sittner/ppp/smps/smps.kicad_pcb

## KiCad design power tram.kicad_sch

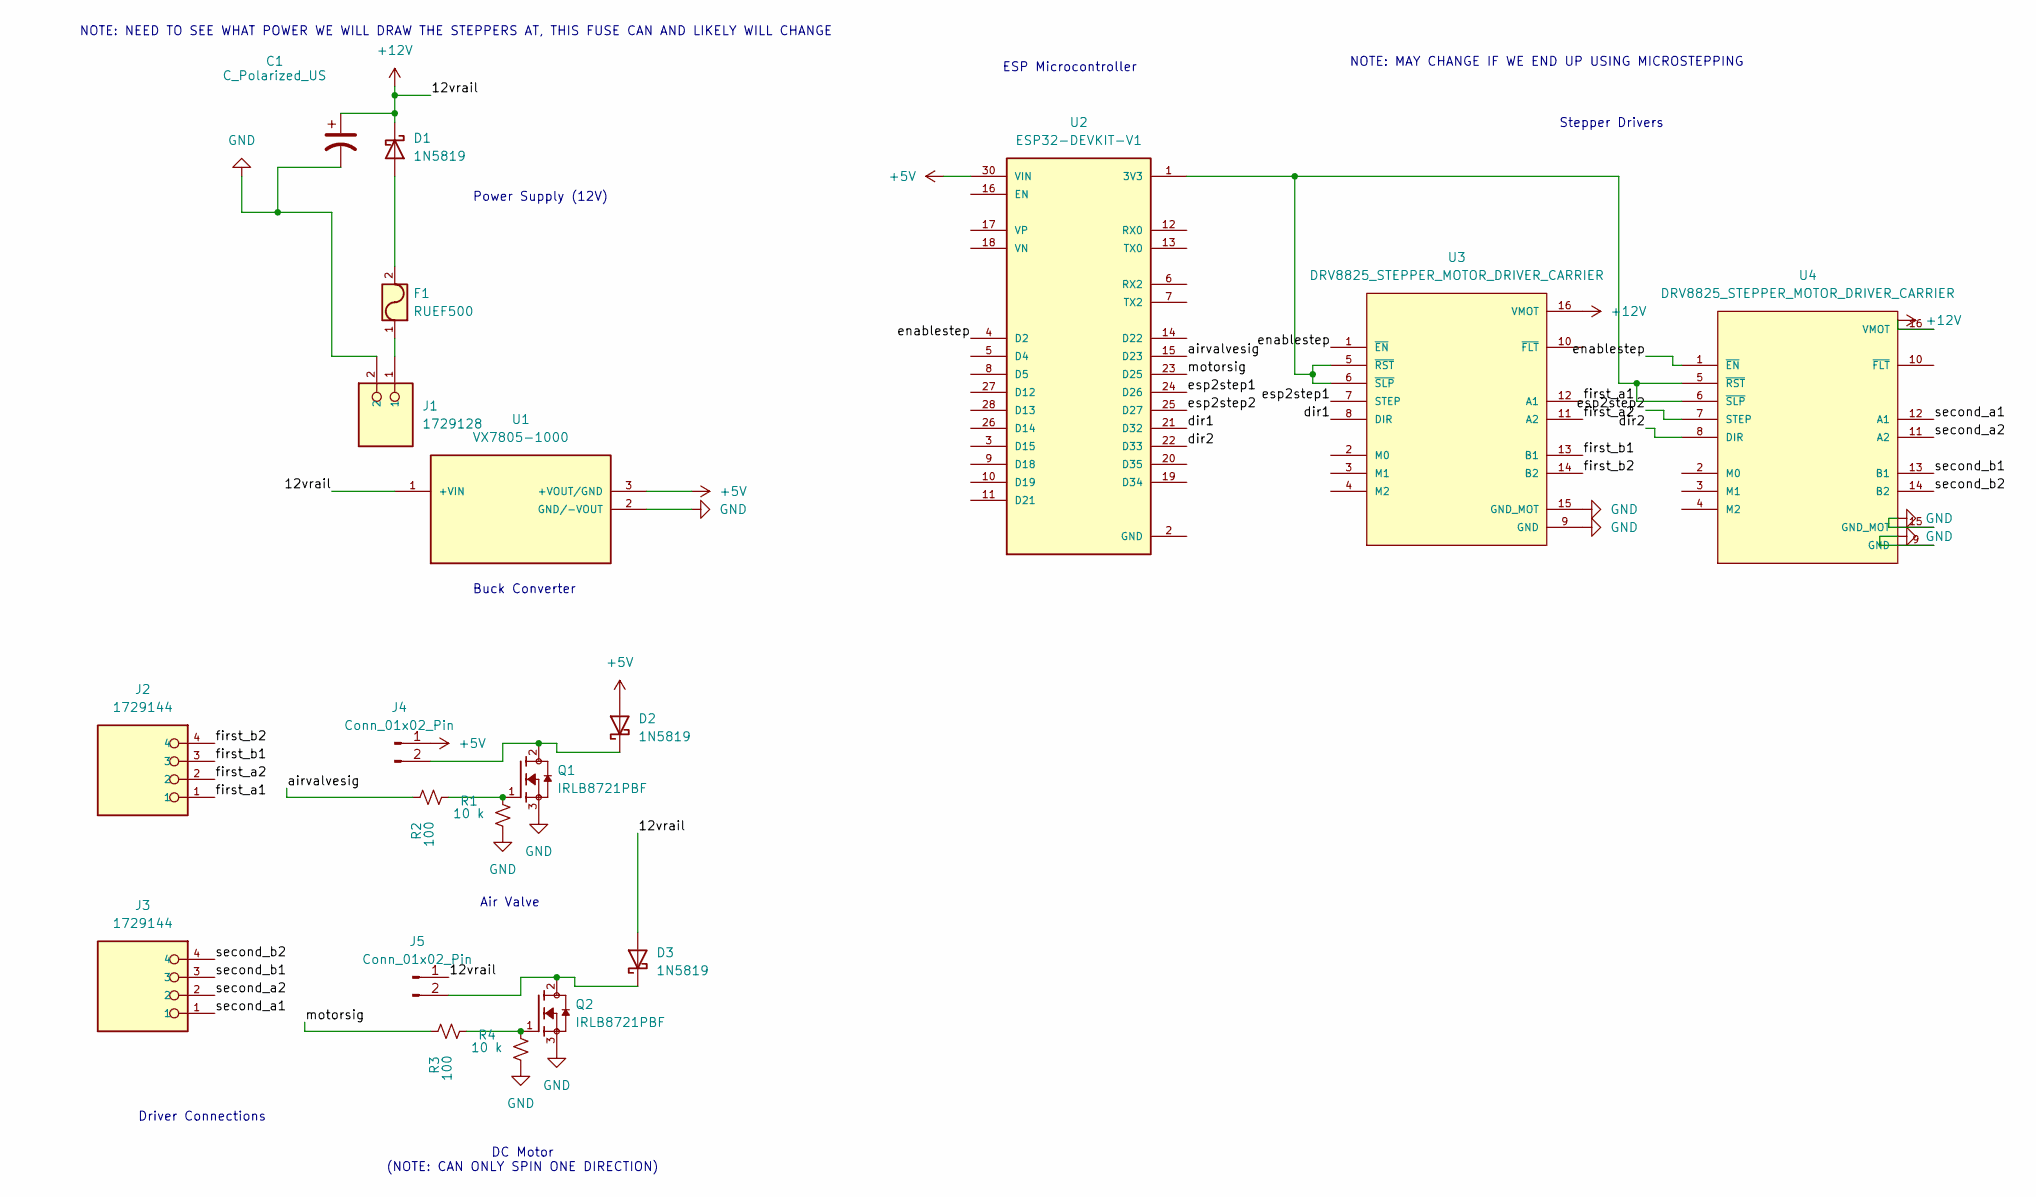
[picture p1: schematic power tram.kicad_sch]

Parts:
C1: C_Polarized_US; CP_Radial_D6.3mm_P2.50mm
D1, D2, D3: 1N5819; D_DO-41_SOD81_P10.16mm_Horizontal
F1: RUEF500; RUEF400; MANUFACTURER_PART_NUMBER RUEF500-2
J1: 1729128; PHOENIX_1729128; PARTREV 28.07.2023
J2, J3: 1729144; PHOENIX_1729144
J4, J5: Conn_01x02_Pin; JST_PH_B2B-PH-K_1x02_P2.00mm_Vertical
Q1, Q2: IRLB8721PBF; TO254P1067X483X2057-3; PARTREV 4/22/09
R1, R4: 10 k; R_Axial_DIN0207_L6.3mm_D2.5mm_P7.62mm_Horizontal
R2, R3: 100; R_Axial_DIN0207_L6.3mm_D2.5mm_P7.62mm_Horizontal
U1: VX7805-1000; VX78012-1000_VX7805-1000; PARTREV 1.0
U2: ESP32-DEVKIT-V1; MODULE_ESP32_DEVKIT_V1; PARTREV N/A
U3, U4: DRV8825_STEPPER_MOTOR_DRIVER_CARRIER; IC_DRV8825_STEPPER_MOTOR_DRIVER_CARRIER

Connections:
+5V: D2.2 (A), J4.1, U1.3 (+VOUT/GND), U2.30 (VIN)
+12V: C1.1, D1.1 (K), D3.2 (A), J5.1, U1.1 (+VIN), U3.16 (VMOT), U4.16 (VMOT)
GND: C1.2, J1.2, Q1.3, Q2.3, R1.2, R4.2, U1.2 (GND/-VOUT), U3.9 (GND), U3.15 (GND_MOT), U4.9 (GND), U4.15 (GND_MOT)
unnamed: D1.2 (A), F1.2
unnamed: D2.1 (K), J4.2, Q1.2
unnamed: D3.1 (K), J5.2, Q2.2
unnamed: F1.1, J1.1
unnamed: Q1.1, R1.1, R2.2
unnamed: Q2.1, R3.2, R4.1
unnamed: U2.1 (3V3), U3.5 (~RST), U3.6 (~SLP), U4.5 (~RST), U4.6 (~SLP)
unnamed: U2.2 (GND), U2.29 (GND)
airvalvesig: R2.1, U2.15 (D23)
dir1: U2.21 (D32), U3.8 (DIR)
dir2: U2.22 (D33), U4.8 (DIR)
enablestep: U2.4 (D2), U3.1 (~EN), U4.1 (~EN)
esp2step1: U2.24 (D26), U3.7 (STEP)
esp2step2: U2.25 (D27), U4.7 (STEP)
first_a1: J2.1, U3.12 (A1)
first_a2: J2.2, U3.11 (A2)
first_b1: J2.3, U3.13 (B1)
first_b2: J2.4, U3.14 (B2)
motorsig: R3.1, U2.23 (D25)
second_a1: J3.1, U4.12 (A1)
second_a2: J3.2, U4.11 (A2)
second_b1: J3.3, U4.13 (B1)
second_b2: J3.4, U4.14 (B2)

Notes on the sheet:
Buck Converter
Power Supply (12V)
Stepper Drivers
Air Valve
DC Motor (NOTE: CAN ONLY SPIN ONE DIRECTION)
NOTE: NEED TO SEE WHAT POWER WE WILL DRAW THE STEPPERS AT, THIS FUSE CAN AND LIKELY WILL CHANGE
Driver Connections
ESP Microcontroller
NOTE: MAY CHANGE IF WE END UP USING MICROSTEPPING
