sittner/ppp/(commit log)

2026-10-20 Add KiCad 9 schematic for PPP 6x EL34 power amp
    Mono amplifier sheet (A2) and mono half of the original stereo power
    supply (A3), linked via global labels. Project library with input,
    output and mains transformer symbols and an EL34 with fixed cathode pin.
    Mains transformer gets aux windings for the Ug bias supplies, output
    transformer uses 0/4/6/8 Ohm taps. ERC clean.
    [amp.kicad_sch, ppp.kicad_sch, supply.kicad_sch]
2026-10-20 Fix bias pot wiring: grid leak resistors to pot wiper
    R19..R24 now connect to the wiper (pin 2) of P1..P6; the pots form the
    divider between the 33k resistors and the bias line.
    [amp.kicad_sch, ppp.kicad_sch, supply.kicad_sch]
2026-10-20 Add AP-634/2 output transformer data to T2
    Value AP-634/2 (EXPERIENCE electronics), Rkk 330 Ohm / >140 W shown on
    the sheet; manufacturer, MPN, secondary taps, core and frequency
    response as symbol fields. Project file expanded to KiCad defaults.
    [amp.kicad_sch]
2026-10-20 Add .gitignore for KiCad backups and local settings
2026-10-20 removed original schematic jpgs
2026-10-20 Add IMPROVEMENTS.md with schematic design review
    Documents component ratings that are exceeded (reservoir caps, bleeders,
    bias caps, LTP tail/anode resistors, ECC81 dissipation), safety/wiring
    issues (EL34 heater-cathode voltage, floating secondary, PE, fuse, bias
    pot fail-safe), smaller improvements and parts checked as OK.
2026-10-20 KT88 variant: 4x KT88 instead of 6x EL34
    - New ppp:KT88 symbol (beam tetrode, pin 1 n.c., no G3 pin)
    - V3-V6 -> KT88, G3-cathode links removed
    - Third output column removed (V7, V8, C13, C14, R23, R24, R29, R30,
    R35, R36, R41, R42, R47, R48, P5, P6)
    - Grid leaks R19-R22 220k -> 150k (KT88 fixed-bias Rg1 max)
    - Titles/notes updated, PDF regenerated
    - KT88.md: feasibility analysis and open points
    [amp.kicad_sch, ppp.kicad_sch, supply.kicad_sch]
2026-10-20 KT88: close gap left by removed third tube column
    Move bias supply, output transformer, speaker terminal and rail labels
    55.88 mm left.
    [amp.kicad_sch]
2026-10-20 KT88: re-centre amplifier sheet on the A2 page
    [amp.kicad_sch]
2026-10-20 KT88: move output stage closer to driver, re-centre sheet
    [amp.kicad_sch]
2026-10-20 KT88: 12.6V heaters, centre grounded at the tubes
    - ECC83/ECC81 in 12.6V mode (pins 4-5), pin 9 to GND
    - KT88 heaters in series strings V3+V4, V5+V6, midpoints to GND
    - Remove hum-balance resistors R49/R50
    - T101: custom transformer, 12.6V 4A heater winding (no CT),
    HV windings 310V 0.35A
    - KT88.md updated
    [amp.kicad_sch, supply.kicad_sch]
2026-10-26 SMPS variant: draft schematic replacing the mains supply
    Replace supply.kicad_sch with two sheets:
    - smps_pri: mains input/EMI filter, NTC + relay bypass, UC3854B PFC
    (390 V bus), fixed-frequency LLC half-bridge (UCC25600 + UCC27714),
    current transformer, startup and aux supply, bus-OK logic.
    - smps_sec: T201, both bank supplies (SiC bridge, CM choke, cap
    multiplier, 52 s B+ delay), heater buck synced from W3.
    Net labels to the amp sheet are unchanged; D5/D6 become UF4007 for the
    100 kHz bias windings. Adds T_SMPS_PPP and UC3854B symbols. Values are
    start values; see SMPS.md for open points.
    [amp.kicad_sch, ppp.kicad_sch, smps_pri.kicad_sch, smps_sec.kicad_sch, supply.kicad_sch]
2026-10-26 added first smps stm based draft
    [smps.kicad_pcb, smps.kicad_sch]
2026-10-26 added missing wire
    [smps.kicad_sch]
2026-10-26 smps: add LLC transformer symbol T_LLC_ETD54
    Project library smps.kicad_sym with the ETD54 LLC transformer:
    9 windings (W1 primary, W2 aux pri, W3 heater, W4/W5/W8 HV, bias
    and aux on M1, W6/W7/W9 on M2), shields S1-S3 and core strap,
    22 pins grouped by bobbin chamber. Registered in sym-lib-table.
